macardenascu/MP3_Electronic_Design/(list of files, drawings)

Other design files:
hardware/altium/MP3_Player/00_System_Top.SchDoc
hardware/altium/MP3_Player/10_Power_Management.SchDoc
hardware/altium/MP3_Player/20_MCU_Core.SchDoc
hardware/altium/MP3_Player/30_USB_Interface.SchDoc
hardware/altium/MP3_Player/40_Storage.SchDoc
hardware/altium/MP3_Player/50_Audio_Codec.SchDoc
hardware/altium/MP3_Player/60_User_Interface.SchDoc
hardware/altium/MP3_Player/MP3_Player.PcbDoc
hardware/altium/MP3_Player/MP3_Player.PrjPcb
