macardenascu/MP3_Electronic_Design/poc/esp32-s31-korvo-1/tests/host/README.md

# Host tests

This compiles the exact portable `main/music_catalog.c` implementation with a tiny ESP error-code shim. It covers missing and non-directory MUSIC paths, empty MUSIC directories, mixed-case extensions, ignored files/directories, deterministic sorting and a long supported filename. The scanner probes each candidate with open/close and reports failures rather than listing inaccessible files.

On a POSIX host with a C11 compiler and CMake:

```sh
cmake -S tests/host -B build-host
cmake --build build-host
./build-host/music_catalog_test
```

The test was run on Windows through MSYS2 GCC with:

```sh
mkdir -p build-host/tmp
export TMPDIR="$PWD/build-host/tmp"
gcc -std=c11 -Wall -Wextra -Werror -I tests/host/include -I main \
  -DMUSIC_CATALOG_OPENDIR=music_catalog_test_opendir \
  main/music_catalog.c tests/host/music_catalog_test.c \
  -o build-host/music_catalog_test
./build-host/music_catalog_test
```

Test fixtures are created under `build-host/` so they remain inside the project. Permission-denied iteration errors are difficult to reproduce reliably when tests run as an administrator/root. The scanner propagates `opendir`, `stat`, `readdir`, and `closedir` failures.
