macardenascu/MP3_Electronic_Design/(commit log)

2026-11-09 docs(hardware): add milestone gates for two-layer PCB
2026-11-09 feat(hardware): integrate native Altium project files
    [00_System_Top.SchDoc, 10_Power_Management.SchDoc, 60_User_Interface.SchDoc, MP3_Player.PcbDoc, MP3_Player.PrjPcb]
2026-11-09 Add MP3_RevA Altium library (rev 2) and ignore Altium temp files
    - Own SchLib/PcbLib/LibPkg for parts missing from the course library:
    ESP32-S3-WROOM-1, PCM5102A, TPA6138A2, MCP73831, AP2112K, AO3401A,
    USB4105, MEM2075, SJ-3523, JST PH. STEP models embedded.
    - Restore USB-C pad B5 (CC2), lost when the footprint was simplified.
    - Ignore Altium History/previews/outputs and the professor's library.
2026-11-09 Make MP3_Player the only Altium project
    hardware/altium/project/ was an older copy (3 sheets) of the active
    project in hardware/altium/MP3_Player/ (7 sheets + PcbDoc). Keep only
    the active one.
    [00_System_Top.SchDoc, 10_Power_Management.SchDoc, 20_MCU_Core.SchDoc, 30_USB_Interface.SchDoc, 40_Storage.SchDoc, 50_Audio_Codec.SchDoc, 60_User_Interface.SchDoc, MP3_Player.PcbDoc]
2026-11-09 Link MP3_RevA SchLib and PcbLib to the MP3_Player project
    [MP3_Player.PrjPcb]
2026-11-11 hardware: esquemáticos Rev A cableados y librería actualizada
    - Hojas 00-60 dibujadas, con recuadros, títulos y cajetín al estilo de la hoja 10
    - Componentes del profesor (shared_lib): USB-C, TP4056, AP2301 y JST
    - MP3_RevA: huellas 0603_res/0603_cap y pasivos 470R, 100k, 2.2uF y 2.2nF
    - Guía de esquemáticos rev 2 con la justificación de los componentes propios
    [00_System_Top.SchDoc, 10_Power_Management.SchDoc, 20_MCU_Core.SchDoc, 30_USB_Interface.SchDoc, 40_Storage.SchDoc, 50_Audio_Codec.SchDoc, 60_User_Interface.SchDoc, MP3_Player.PrjPcb]
2026-11-11 hardware: ajuste de designadores en hojas 10, 20, 50 y 60
    [10_Power_Management.SchDoc, 20_MCU_Core.SchDoc, 50_Audio_Codec.SchDoc, 60_User_Interface.SchDoc]
2026-11-11 hardware: colocación de componentes completa (placa 65x90 mm)
    [00_System_Top.SchDoc, 10_Power_Management.SchDoc, 20_MCU_Core.SchDoc, 30_USB_Interface.SchDoc, 40_Storage.SchDoc, 50_Audio_Codec.SchDoc, 60_User_Interface.SchDoc, MP3_Player.PcbDoc]
2026-11-12 hardware: actualiza PcbDoc
    [MP3_Player.PcbDoc]
2026-11-12 hardware: PCB terminada (ruteo, polígonos y serigrafía)
    [MP3_Player.PcbDoc]
2026-11-12 docs(hardware): actualiza README con el estado final de Rev A
    Claude-Session: https://claude.ai/code/session_013HtPoctbFwPN8steDBK2mA
2026-11-12 docs(hardware): actualiza README de librería y plan de trabajo Rev A
    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
2026-11-12 hardware: ajustes estéticos en esquemáticos y PCB
    [00_System_Top.SchDoc, 10_Power_Management.SchDoc, 20_MCU_Core.SchDoc, 30_USB_Interface.SchDoc, 40_Storage.SchDoc, 50_Audio_Codec.SchDoc, 60_User_Interface.SchDoc, MP3_Player.PcbDoc]
2026-11-12 hardware: alinea a la rejilla de 50 mil los objetos off-grid en 30/40/60
    [00_System_Top.SchDoc, 10_Power_Management.SchDoc, 20_MCU_Core.SchDoc, 30_USB_Interface.SchDoc, 40_Storage.SchDoc, 50_Audio_Codec.SchDoc, 60_User_Interface.SchDoc, MP3_Player.PcbDoc]
2026-11-12 docs: actualiza README principal con la arquitectura de la PCB Rev A
    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
2026-11-13 hardware: agrega logo en Bottom Overlay del PCB
    Logo del dinosaurio (~18.5 x 22 mm) generado desde Logos/dino_mirrored.bmp
    como 604 pistas de serigrafía de 5 mil agrupadas en una Union, en la zona
    inferior derecha de la cara Bottom, libre de pads, vias y aberturas de
    máscara y a >= 1 mm del borde. Sin cambios eléctricos. README actualizado.
    [MP3_Player.PcbDoc]
2026-11-13 docs(hardware): marca Rev A como diseño congelado; test points, rótulos de botones y logo
    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
2026-11-13 hardware: test points en esquemáticos y librería
    [00_System_Top.SchDoc, 10_Power_Management.SchDoc, 20_MCU_Core.SchDoc, 30_USB_Interface.SchDoc, 40_Storage.SchDoc, 50_Audio_Codec.SchDoc, 60_User_Interface.SchDoc, MP3_Player.PcbDoc]
